jesse7chen/PotholeDetection/imgs/31520605_10160335774905300_6558092161055719424_n.jpg

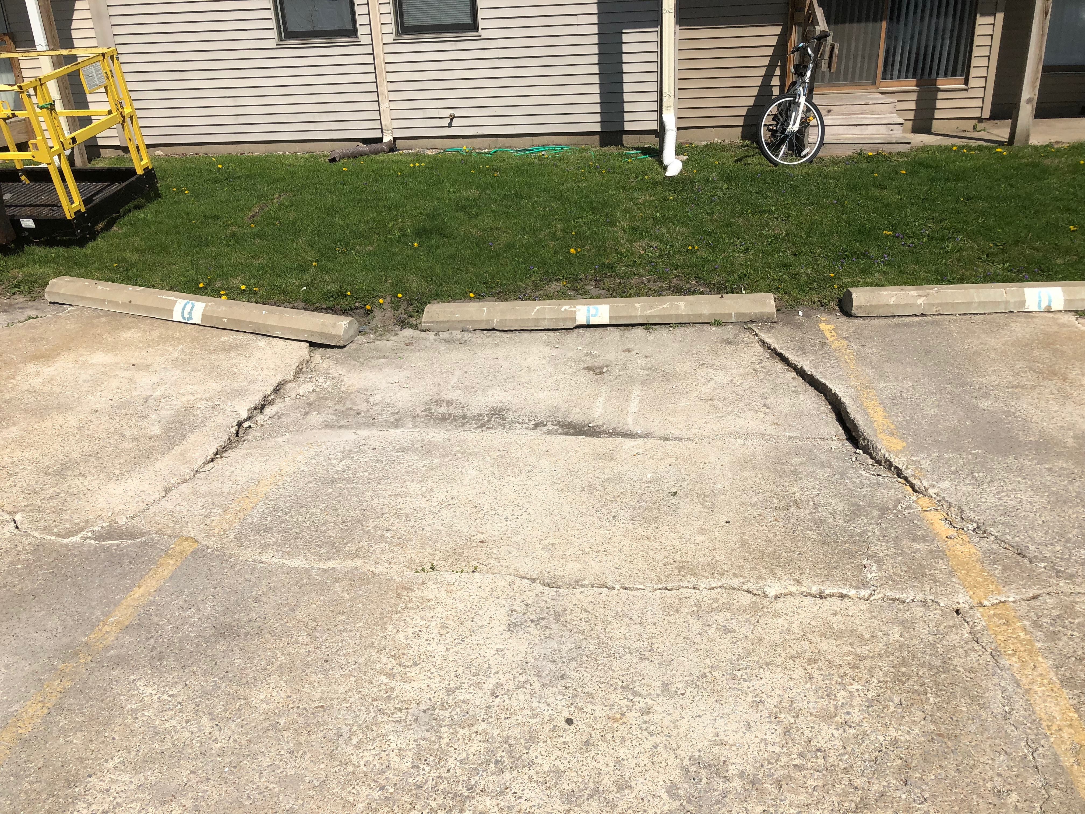
imgs/31520605_10160335774905300_6558092161055719424_n.jpg
