jesse7chen/PotholeDetection/bsp.h

#ifndef _BSP_H_
#define _BSP_H_

// Old GPS timer based code
// void TIMER32_0_IRQHandler(void);
void TIMER32_1_IRQHandler(void);
void TIMER16_0_IRQHandler(void);
void TIMER16_1_IRQHandler(void);
void UART_IRQHandler(void);
void PIOINT1_IRQHandler(void);

#endif /* _BSP_H_ */
