jesse7chen/PotholeDetection/GPS.h

#ifndef _GPS_H_
#define _GPS_H_

#include <stdint.h>

// Sorry that the enum instances aren't capitalized...
typedef enum locationStatus {valid, invalid, stale} locationStatus;

typedef enum gpsReadStatus_t {START_CHAR, FIRST_END_CHAR, SECOND_END_CHAR, MSG_READY} gpsReadStatus_t;

typedef struct location_t 
{
    double latitude;
    double longitude;
    double speed;
    double bearing;
    locationStatus status;
} location_t;

// Main functions
int GPS_init(void);

void readGPS(void);

void processGPS(void);

int readNMEA_UART(void);

// Getters and setters
void resetGPSstatus(void);

unsigned int getGPSstatus(void);

unsigned int getGPSreadSuccess(void);

void resetGPSreadSuccess(void);

void resetGPSbuffer(void);

gpsReadStatus_t getGPSreadStatus(void);

location_t getCurrLocation(void);

// Test/debugging functions
void testNMEA(void);

void printLocation(void);

void blePrintBuffer(void);

// Static helper functions
static double simple_strtod(const char* str);

static int readNMEA(void);

static int calcBufferChecksum(void);

static int verifyChecksum(void);

static int parseNMEA(void);

static int parseRMC(void);

static double dec_minutes_to_dec_degrees(char* dec_minutes, int isLat);

static double knots_to_mph(double knots);


#endif /* _GPS_H_ */
