jesse7chen/PotholeDetection/LED.c

#include "LED.h"
#include "LPC11xx.h"

static unsigned int ledStatus = 0;

void ledInit(void)
{

	//set port 0_7 to output (high current drain in LPC1114)
    LPC_GPIO0->DIR |= (1<<7);
    //LPC_GPIO0->DIR |= (1UL << 6);
    //LPC_GPIO0->DIR |= (1UL << 9);
}

void ledOn(void)
{
	LPC_GPIO0->DATA &= ~(1<<7);
    ledStatus = 1;
}

void ledOff(void)
{						 
	LPC_GPIO0->DATA |= (1<<7);
    ledStatus = 0;
}

void toggleLED(void){
    if(ledStatus){
        ledOff();
        ledStatus = 0;
    }
    else{
        ledOn();
        ledStatus = 1;
    }
}
