jesse7chen/PotholeDetection/test_database.h

#ifndef _TEST_DATABASE_H_
#define _TEST_DATABASE_H_

static database_loc_t test_database[10] = {{.latitude = 40.116520, .longitude = -88.229346}, 
{.latitude = 40.110590, .longitude = -88.229039},
{.latitude = 40.116403, .longitude = -88.229007}, // By Hammerhead coffee
{.latitude = 40.112923, .longitude = -88.228964}, // By Wright and Springfield
{.latitude = 40.112807, .longitude = -88.228959}, // Also by Wright and Springfield
{.latitude = 40.114923, .longitude = -88.227452}, // In between ECEB and CSL
{.latitude = 40.113505, .longitude = -88.232019}, // Stoughton and Fifth
{.latitude = 40.111486, .longitude = -88.232043}, // Healy and Fifth
{.latitude = 40.104084, .longitude = -88.235047}, // Just north of Ike
{.latitude = 40.104190, .longitude = -88.221915} // Just by CRCE
};




#endif /* _TEST_DATABASE_H */
