jesse7chen/PotholeDetection/(commit log)

2018-04-07 Initial commit (SPI, UART, BLE, GPS, button done)
2018-04-19 Fixed flash database issues, integrating all units
    [GPS.c, GPS.h, LED.c, UART.c, bluetooth.c, bluetooth.h, bsp.c]
2018-04-20 UART changed to interrupt based, GPS baudrate increased
2018-04-20 Added distance check for database insertion
2018-04-20 Added computer vision detection interrupt
2018-04-20 Integrated accelerometer/I2C
2018-04-20 Changed accelerometer prescale back to 40000
2018-04-20 Currently debugging accelerometer
2018-04-21 Add files via upload
    Runs on your computer to check the camera output to fine tune parameters
2018-04-22 Fixed accelerometer
